Hyiger-Designs/max_breakout/README.md

# MAX7000S Breakout Board
A breadboard and 5V TLL friendly CPLD breakout board
