Hyiger-Designs/max_breakout/images/max_breakout_back.png

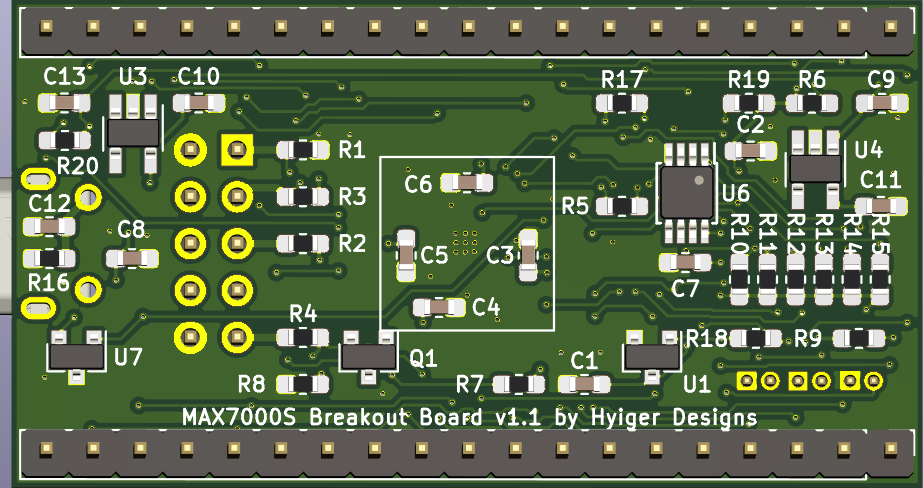
images/max_breakout_back.png
