Hyiger-Designs/max_breakout/images/max_breakout_front.png

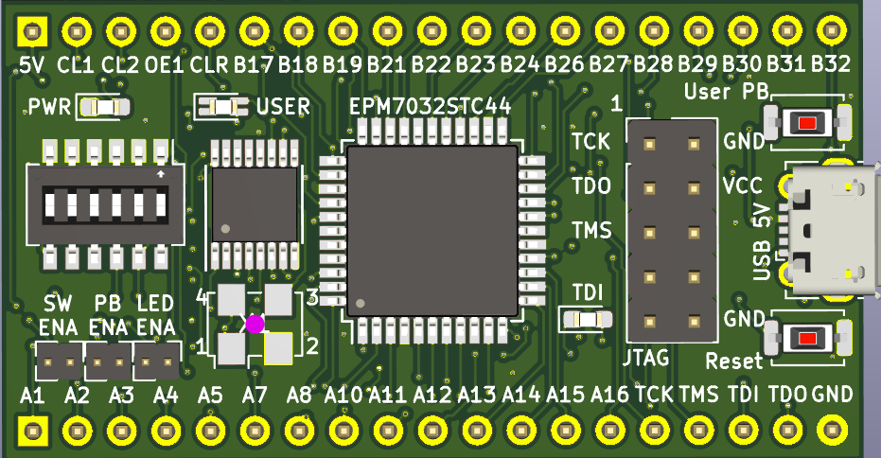
images/max_breakout_front.png
