Hyiger-Designs/max_breakout/max_breakout.xlsx

Refs | Description | MFR | MPN | SPN | SPR | SPURL | datasheet | Footprint | value
C1 | Multilayer Ceramic Capacitors MLCC - SMD/SMT 0603 6.3V 2.2uF 10% X7R | Murata | JMK107B7474KA-T | 963-JMK107B7474KA-T | Mouser | https://www.mouser.com/ProductDetail/963-JMK107B7474KA-T | https://www.mouser.com/datasheet/2/396/mlcc02_e-1307760.pdf | Capacitor_SMD:C_0603_1608Metric_Pad1.05x0.95mm_HandSolder | 2.2uF
C10 | Multilayer Ceramic Capacitors MLCC - SMD/SMT 0603 6.3V 0.33uF 10% X7R | Murata | JMK107B7474KA-T | 963-JMK107B7474KA-T | Mouser | https://www.mouser.com/ProductDetail/963-JMK107B7474KA-T | https://www.mouser.com/datasheet/2/396/mlcc02_e-1307760.pdf | Capacitor_SMD:C_0603_1608Metric_Pad1.05x0.95mm_HandSolder | .33uF
C11 | Multilayer Ceramic Capacitors MLCC - SMD/SMT 0603 6.3V 0..33uF 10% X7R | Murata | JMK107B7474KA-T | 963-JMK107B7474KA-T | Mouser | https://www.mouser.com/ProductDetail/963-JMK107B7474KA-T | https://www.mouser.com/datasheet/2/396/mlcc02_e-1307760.pdf | Capacitor_SMD:C_0603_1608Metric_Pad1.05x0.95mm_HandSolder | .33uF
C12 | Multilayer Ceramic Capacitors MLCC - SMD/SMT 0603 6.3V 100nF 10% X7R | Murata | JMK107B7474KA-T | 963-JMK107B7474KA-T | Mouser | https://www.mouser.com/ProductDetail/963-JMK107B7474KA-T | https://www.mouser.com/datasheet/2/396/mlcc02_e-1307760.pdf | Capacitor_SMD:C_0603_1608Metric_Pad1.05x0.95mm_HandSolder | 100nF
C13 | Multilayer Ceramic Capacitors MLCC - SMD/SMT 0603 6.3V 100nF 10% X7R | Murata | TMK107BJ104KA-T | 963-TMK107BJ104KA-T | Mouser | https://www.mouser.com/ProductDetail/963-TMK107BJ104KA-T | https://www.mouser.com/datasheet/2/396/mlcc02_e-1307760.pdf | Capacitor_SMD:C_0603_1608Metric_Pad1.05x0.95mm_HandSolder | 100nF
C2 | Multilayer Ceramic Capacitors MLCC - SMD/SMT 0603 6.3V 100nF 10% X7R | Murata | JMK107B7474KA-T | 963-JMK107B7474KA-T | Mouser | https://www.mouser.com/ProductDetail/963-JMK107B7474KA-T | https://www.mouser.com/datasheet/2/396/mlcc02_e-1307760.pdf | Capacitor_SMD:C_0603_1608Metric_Pad1.05x0.95mm_HandSolder | 100nF
C3 | Multilayer Ceramic Capacitors MLCC - SMD/SMT 0603 6.3V 100nF 10% X7R | Murata | JMK107B7474KA-T | 963-JMK107B7474KA-T | Mouser | https://www.mouser.com/ProductDetail/963-JMK107B7474KA-T | https://www.mouser.com/datasheet/2/396/mlcc02_e-1307760.pdf | Capacitor_SMD:C_0603_1608Metric_Pad1.05x0.95mm_HandSolder | 100nF
C4 | Multilayer Ceramic Capacitors MLCC - SMD/SMT 0603 6.3V 100nF 10% X7R | Murata | JMK107B7474KA-T | 963-JMK107B7474KA-T | Mouser | https://www.mouser.com/ProductDetail/963-JMK107B7474KA-T | https://www.mouser.com/datasheet/2/396/mlcc02_e-1307760.pdf | Capacitor_SMD:C_0603_1608Metric_Pad1.05x0.95mm_HandSolder | 100nF
C5 | Multilayer Ceramic Capacitors MLCC - SMD/SMT 0603 6.3V 100nF 10% X7R | Murata | JMK107B7474KA-T | 963-JMK107B7474KA-T | Mouser | https://www.mouser.com/ProductDetail/963-JMK107B7474KA-T | https://www.mouser.com/datasheet/2/396/mlcc02_e-1307760.pdf | Capacitor_SMD:C_0603_1608Metric_Pad1.05x0.95mm_HandSolder | 100nF
C7 | Multilayer Ceramic Capacitors MLCC - SMD/SMT 0603 6.3V 100nF 10% X7R | Murata | JMK107B7474KA-T | 963-JMK107B7474KA-T | Mouser | https://www.mouser.com/ProductDetail/963-JMK107B7474KA-T | https://www.mouser.com/datasheet/2/396/mlcc02_e-1307760.pdf | Capacitor_SMD:C_0603_1608Metric_Pad1.05x0.95mm_HandSolder | 100nF
C8 | Multilayer Ceramic Capacitors MLCC - SMD/SMT 0603 6.3V 0.33uF 10% X7R | Murata | JMK107B7474KA-T | 963-JMK107B7474KA-T | Mouser | https://www.mouser.com/ProductDetail/963-JMK107B7474KA-T | https://www.mouser.com/datasheet/2/396/mlcc02_e-1307760.pdf | Capacitor_SMD:C_0603_1608Metric_Pad1.05x0.95mm_HandSolder | .33uF
C9 | Multilayer Ceramic Capacitors MLCC - SMD/SMT 0603 6.3V 0.33uF 10% X7R | Murata | JMK107B7474KA-T | 963-JMK107B7474KA-T | Mouser | https://www.mouser.com/ProductDetail/963-JMK107B7474KA-T | https://www.mouser.com/datasheet/2/396/mlcc02_e-1307760.pdf | Capacitor_SMD:C_0603_1608Metric_Pad1.05x0.95mm_HandSolder | .33uF
D1 | Standard LEDs - SMD RED WATER CLEAR | Kingbright | APT1608EC | 604-APT1608EC | Mouser | https://www.mouser.com/ProductDetail/604-APT1608EC | https://www.mouser.com/datasheet/2/216/APT1608EC-34957.pdf | LED_SMD:LED_0603_1608Metric_Pad1.05x0.95mm_HandSolder | Red
D2 | Standard LEDs - SMD GREEN WATER CLEAR | Kingbright | APT1608SGC | 604-APT1608SGC | Mouser | https://www.mouser.com/ProductDetail/604-APT1608SGC | https://www.mouser.com/datasheet/2/216/APT1608SGC-32861.pdf | LED_SMD:LED_0603_1608Metric_Pad1.05x0.95mm_HandSolder | Green
D3 | Standard LEDs - SMD RGB LED | Inolux | IN-S85TATRGB | 743-IN-S85TATRGB | Mouser | https://www.mouser.com/ProductDetail/Inolux/IN-S85TATRGB | https://www.mouser.com/datasheet/2/180/IN-S85TATRGB_V1.0-1488493.pdf | LED_SMD:IN-S85TATRGB | RGB
J1 |  |  |  |  |  |  | ~ | Connector_PinHeader_2.54mm:PinHeader_1x19_P2.54mm_Vertical | Left
J2 |  |  |  |  |  |  | ~ | Connector_PinHeader_2.54mm:PinHeader_1x19_P2.54mm_Vertical | Right
J3 |  |  |  |  |  |  | ~ | Connector_PinHeader_2.54mm:PinHeader_2x05_P2.54mm_Vertical | AVR-JTAG-10
J4 | USB Connectors 5P Quick Connect Micro USB TypeB Rcpt | Amphenol | 10103594-0001LF | 649-10103594-0001LF | Mouser | https://www.mouser.com/ProductDetail/649-10103594-0001LF | https://www.mouser.com/datasheet/2/18/10103594-1361315.pdf | Connector_USB:USB_Micro-B_Amphenol_10103594-0001LF_Horizontal | USB_B_Micro
Q1 | MOSFET MOSFT P-Ch -3.7A 65mOhm 8nC Log Lvl | Infineon | RLML6402TRPBF | 942-IRLML6402TRPBF | Mouser | https://www.mouser.com/ProductDetail/Infineon-Technologies/IRLML6402TRPBF | https://www.infineon.com/dgdl/irlml6402pbf.pdf?fileId=5546d462533600a401535668d5c2263c | Package_TO_SOT_SMD:SOT-23 | IRLML6402
R1 | Thick Film Resistors - SMD 1K OHM 1% | Bourns | CR0603-FX-1001ELF | 652-CR0603FX-1001ELF | Mouser | https://www.mouser.com/ProductDetail/Bourns/CR0603-FX-1001ELF | https://www.mouser.com/datasheet/2/54/hpreztr-777398.pdf | Resistor_SMD:R_0603_1608Metric_Pad1.05x0.95mm_HandSolder | 1K
R10 | Thick Film Resistors - SMD 10K OHM 1% | Bourns | CR0603-FX-1002ELF | 652-CR0603FX-1002ELF | Mouser | https://www.mouser.com/ProductDetail/Bourns/CR0603-FX-1002ELF | https://www.mouser.com/datasheet/2/54/hpreztr-777398.pdf | Resistor_SMD:R_0603_1608Metric_Pad1.05x0.95mm_HandSolder | 10K
R11 | Thick Film Resistors - SMD 10K OHM 1% | Bourns | CR0603-FX-1002ELF | 652-CR0603FX-1002ELF | Mouser | https://www.mouser.com/ProductDetail/Bourns/CR0603-FX-1002ELF | https://www.mouser.com/datasheet/2/54/hpreztr-777398.pdf | Resistor_SMD:R_0603_1608Metric_Pad1.05x0.95mm_HandSolder | 10K
R12 | Thick Film Resistors - SMD 10K OHM 1% | Bourns | CR0603-FX-1002ELF | 652-CR0603FX-1002ELF | Mouser | https://www.mouser.com/ProductDetail/Bourns/CR0603-FX-1002ELF | https://www.mouser.com/datasheet/2/54/hpreztr-777398.pdf | Resistor_SMD:R_0603_1608Metric_Pad1.05x0.95mm_HandSolder | 10K
R13 | Thick Film Resistors - SMD 10K OHM 1% | Bourns | CR0603-FX-1002ELF | 652-CR0603FX-1002ELF | Mouser | https://www.mouser.com/ProductDetail/Bourns/CR0603-FX-1002ELF | https://www.mouser.com/datasheet/2/54/hpreztr-777398.pdf | Resistor_SMD:R_0603_1608Metric_Pad1.05x0.95mm_HandSolder | 10K
R14 | Thick Film Resistors - SMD 10K OHM 1% | Bourns | CR0603-FX-1002ELF | 652-CR0603FX-1002ELF | Mouser | https://www.mouser.com/ProductDetail/Bourns/CR0603-FX-1002ELF | https://www.mouser.com/datasheet/2/54/hpreztr-777398.pdf | Resistor_SMD:R_0603_1608Metric_Pad1.05x0.95mm_HandSolder | 10K
R15 | Thick Film Resistors - SMD 10K OHM 1% | Bourns | CR0603-FX-1002ELF | 652-CR0603FX-1002ELF | Mouser | https://www.mouser.com/ProductDetail/Bourns/CR0603-FX-1002ELF | https://www.mouser.com/datasheet/2/54/hpreztr-777398.pdf | Resistor_SMD:R_0603_1608Metric_Pad1.05x0.95mm_HandSolder | 10K
R16 | Thick Film Resistors - SMD 1M OHM 1% | Bourns | CR0603-FX-1004ELF | 652-CR0603FX-1004ELF | Mouser | https://www.mouser.com/ProductDetail/603-RC0603JR-071ML | https://www.mouser.com/datasheet/2/54/hpreztr-777398.pdf | Resistor_SMD:R_0603_1608Metric_Pad1.05x0.95mm_HandSolder | 1M
R18 | Thick Film Resistors - SMD 360R 1% | Bourns | CR0603-FX-3600ELF | 652-CR0603FX-3600ELF | Mouser | https://www.mouser.com/ProductDetail/Bourns/CR0603-FX-3600ELF | https://www.mouser.com/datasheet/2/54/hpreztr-777398.pdf | Resistor_SMD:R_0603_1608Metric_Pad1.05x0.95mm_HandSolder | 360R
R2 | Thick Film Resistors - SMD 10K OHM 1% | Bourns | CR0603-FX-1002ELF | 652-CR0603FX-1002ELF | Mouser | https://www.mouser.com/ProductDetail/Bourns/CR0603-FX-1002ELF | https://www.mouser.com/datasheet/2/54/hpreztr-777398.pdf | Resistor_SMD:R_0603_1608Metric_Pad1.05x0.95mm_HandSolder | 10K
R3 | Thick Film Resistors - SMD 10K OHM 1% | Bourns | CR0603-FX-1002ELF | 652-CR0603FX-1002ELF | Mouser | https://www.mouser.com/ProductDetail/Bourns/CR0603-FX-1002ELF | https://www.mouser.com/datasheet/2/54/hpreztr-777398.pdf | Resistor_SMD:R_0603_1608Metric_Pad1.05x0.95mm_HandSolder | 10K
R4 | Thick Film Resistors - SMD 10K OHM 1% | Bourns | CR0603-FX-1002ELF | 652-CR0603FX-1002ELF | Mouser | https://www.mouser.com/ProductDetail/Bourns/CR0603-FX-1002ELF | https://www.mouser.com/datasheet/2/54/hpreztr-777398.pdf | Resistor_SMD:R_0603_1608Metric_Pad1.05x0.95mm_HandSolder | 10K
R5 | Thick Film Resistors - SMD 100R OHM 1% | Bourns | CR0603-FX-1000ELF | 652-CR0603FX-1000ELF | Mouser | https://www.mouser.com/ProductDetail/Bourns/CR0603-FX-1000ELF | https://www.mouser.com/datasheet/2/54/hpreztr-777398.pdf | Resistor_SMD:R_0603_1608Metric_Pad1.05x0.95mm_HandSolder | 100R
R6 | Thick Film Resistors - SMD 360R 1% | Bourns | CR0603-FX-3600ELF | 652-CR0603FX-3600ELF | Mouser | https://www.mouser.com/ProductDetail/Bourns/CR0603-FX-3600ELF | https://www.mouser.com/datasheet/2/54/hpreztr-777398.pdf | Resistor_SMD:R_0603_1608Metric_Pad1.05x0.95mm_HandSolder | 360R
R7 | Thick Film Resistors - SMD 100R OHM 1% | Bourns | CR0603-FX-1000ELF | 652-CR0603FX-1000ELF | Mouser | https://www.mouser.com/ProductDetail/Bourns/CR0603-FX-1000ELF | https://www.mouser.com/datasheet/2/54/hpreztr-777398.pdf | Resistor_SMD:R_0603_1608Metric_Pad1.05x0.95mm_HandSolder | 100R
R8 | Thick Film Resistors - SMD 360R 1% | Bourns | CR0603-FX-3600ELF | 652-CR0603FX-3600ELF | Mouser | https://www.mouser.com/ProductDetail/Bourns/CR0603-FX-3600ELF | https://www.mouser.com/datasheet/2/54/hpreztr-777398.pdf | Resistor_SMD:R_0603_1608Metric_Pad1.05x0.95mm_HandSolder | 360R
R9 | Thick Film Resistors - SMD 10K OHM 1% | Bourns | CR0603-FX-1002ELF | 652-CR0603FX-1002ELF | Mouser | https://www.mouser.com/ProductDetail/Bourns/CR0603-FX-1002ELF | https://www.mouser.com/datasheet/2/54/hpreztr-777398.pdf | Resistor_SMD:R_0603_1608Metric_Pad1.05x0.95mm_HandSolder | 10K
SW1 | Tactile Switches 3.9x2.9x2.0mm 160gf Packaging Temp 80oC | ALPS | SKRKAEE020 | 688-SKRKAEE020 | Mouser | https://www.mouser.com/ProductDetail/688-SKRKAEE020 | https://www.mouser.com/datasheet/2/15/SKRK-1370789.pdf | Button_Switch_SMD:SW_Push_SPST_NO_Alps_SKRK | Reset
SW2 | Tactile Switches 3.9x2.9x2.0mm 160gf Packaging Temp 80oC | ALPS | SKRKAEE020 | 688-SKRKAEE020 | Mouser | https://www.mouser.com/ProductDetail/688-SKRKAEE020 | https://www.mouser.com/datasheet/2/15/SKRK-1370789.pdf | Button_Switch_SMD:SW_Push_SPST_NO_Alps_SKRK | User
SW3 |  |  |  |  | Mouser |  | https://www.mouser.com/datasheet/2/307/en-a6h-1221378.pdf | Button_Switch_SMD:SW_DIP_SPSTx04_Slide_KingTek_DSHP04TS_W7.62mm_P1.27mm | User DIP Switch
SW4 |  |  |  |  | Mouser |  | https://www.mouser.com/datasheet/2/307/en-a6h-1221378.pdf | Button_Switch_SMD:SW_DIP_SPSTx04_Slide_KingTek_DSHP04TS_W7.62mm_P1.27mm | ENA Switch
U1 | LDO Voltage Regulators LDO CMOS LowCurr SOT23 T&R 3K | Diodes Inc | AP7381-33SA-7 | 621-AP7381-33SA-7 | Mouser | https://www.mouser.com/ProductDetail/Diodes-Incorporated/AP7381-33SA-7 | https://www.mouser.com/datasheet/2/115/AP7381-1220674.pdf | Package_TO_SOT_SMD:SOT-23 | AP7381-33SA
U2 | CPLD 32MC 10NS 44TQFP | Intel | EPM7032STC44-10FN |  |  |  | https://media.digikey.com/pdf/Data%20Sheets/Intel%20PDFs/MAX7000_Family_DS.pdf | Package_QFP:TQFP-44_10x10mm_P0.8mm_ThermalVias | EPM7032STC44
U3 | Supervisory Circuits 5V EconoReset w/Pushbutton | Maxim | DS1813R-5+T&R | 700-DS1813R-5T&R | Mouser | https://www.mouser.com/ProductDetail/Maxim-Integrated/DS1813R-5%2BTR?qs=Jw2w9zrI6w%2FjFaF2gE5%2Fbg%3D%3D | https://www.mouser.com/datasheet/2/256/maxim%20integrated%20products_ds1813-1178753.pdf | Package_TO_SOT_SMD:SOT-23 | DS1813R-5+T&R
U4 | Supervisory Circuits Current Sense/Ideal Diode | Maxim | MAX40200AUK+T | 700-MAX40200AUK+T | Mouser | https://www.mouser.com/ProductDetail/Maxim-Integrated/MAX40200AUK%2BT?qs=5aG0NVq1C4yORXmgClGWGQ%3D%3D | https://www.mouser.com/datasheet/2/256/MAX40200-1112995.pdf | Package_TO_SOT_SMD:SOT-23-5_HandSoldering | MAX40200AUK
U5 | Supervisory Circuits Current Sense/Ideal Diode | Maxim | MAX40200AUK+T | 700-MAX40200AUK+T | Mouser | https://www.mouser.com/ProductDetail/Maxim-Integrated/MAX40200AUK%2BT?qs=5aG0NVq1C4yORXmgClGWGQ%3D%3D | https://www.mouser.com/datasheet/2/256/MAX40200-1112995.pdf | Package_TO_SOT_SMD:SOT-23-5_HandSoldering | MAX40200AUK
U6 | Buffers & Line Drivers OCTAL BUFFER 3-STATE | Nexperia | 74HCT244PW,118 | 771-HCT244PW118 | Mouser | https://www.mouser.com/ProductDetail/Nexperia/74HCT244PW118?qs=sGAEpiMZZMuiiWkaIwCK2RTxPVPWGz6W2P5hwMtP2Rs%3D | https://assets.nexperia.com/documents/data-sheet/74HC_HCT244.pdf | Package_SO:TSSOP-20_4.4x6.5mm_P0.65mm | 74HCT244
X1 | 50Mhz Clock Oscillator, 3.3V, HCMOS,TTL | CTS | 636L3C050M00000 | 774-636L3C050M00000 | Mouser | https://www.mouser.com/ProductDetail/CTS-Electronic-Components/636L3C050M00000 | https://www.mouser.com/datasheet/2/96/008-0250-0-786318.pdf | Oscillator:Oscillator_SMD_TXC_7C-4Pin_5.0x3.2mm_HandSoldering | CTX-636 50mhz
