Hyiger-Designs/max_breakout/docs/max_breakout.pdf

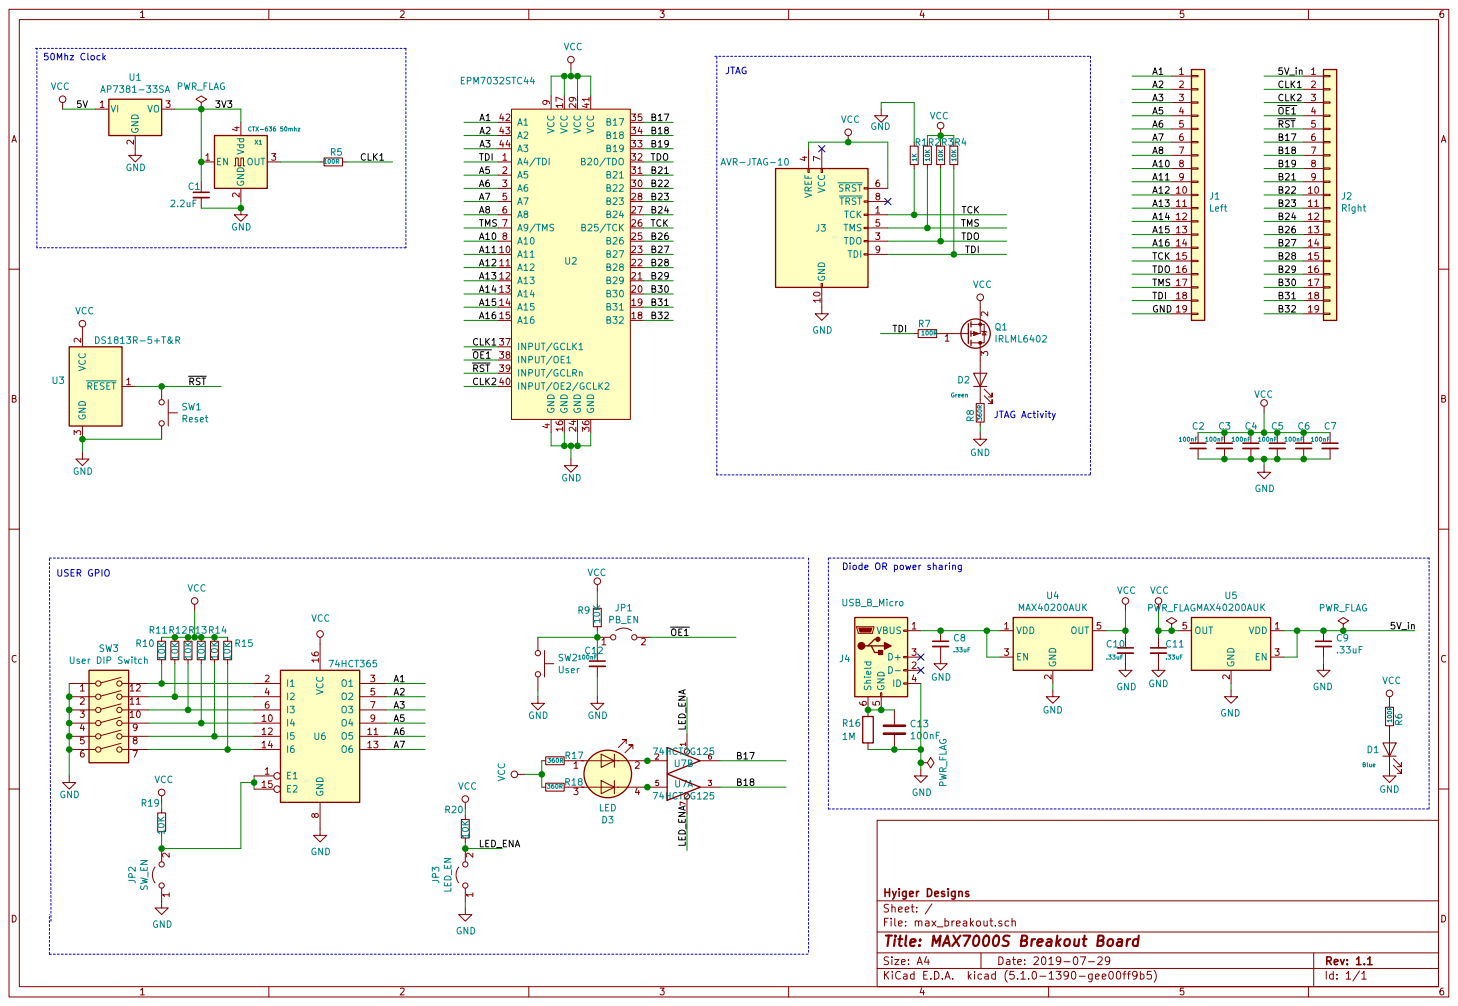
[picture p3: page 1]

Diode OR power sharing

File: max_breakout.sch Sheet: / Hyiger Designs

Id: 1/1 Title: MAX7000S Breakout Board
