Hyiger-Designs/max_breakout/max_breakout_sch.pdf

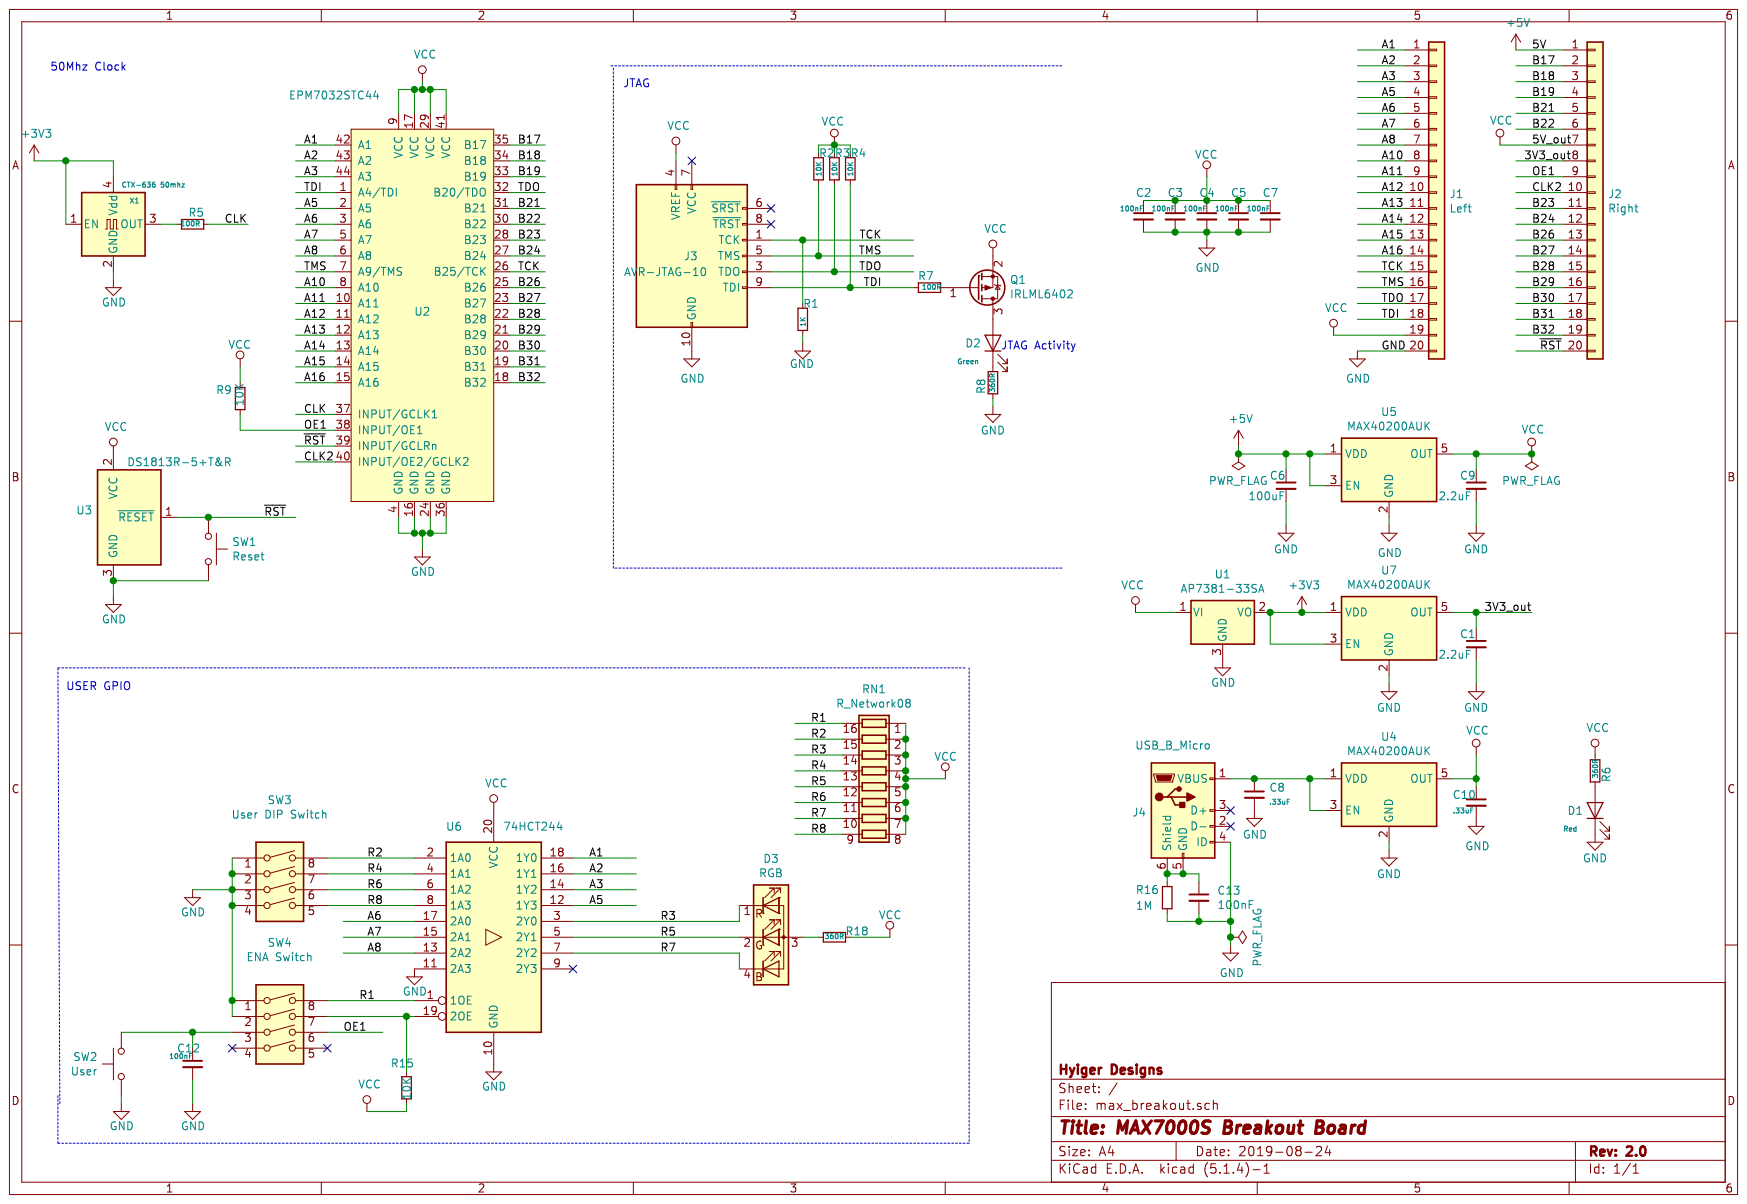
[picture p4: page 1]
