Hyiger-Designs/max_breakout/max_breakout.kicad_pcb

## KiCad design max_breakout.kicad_pcb (2021-03-13)

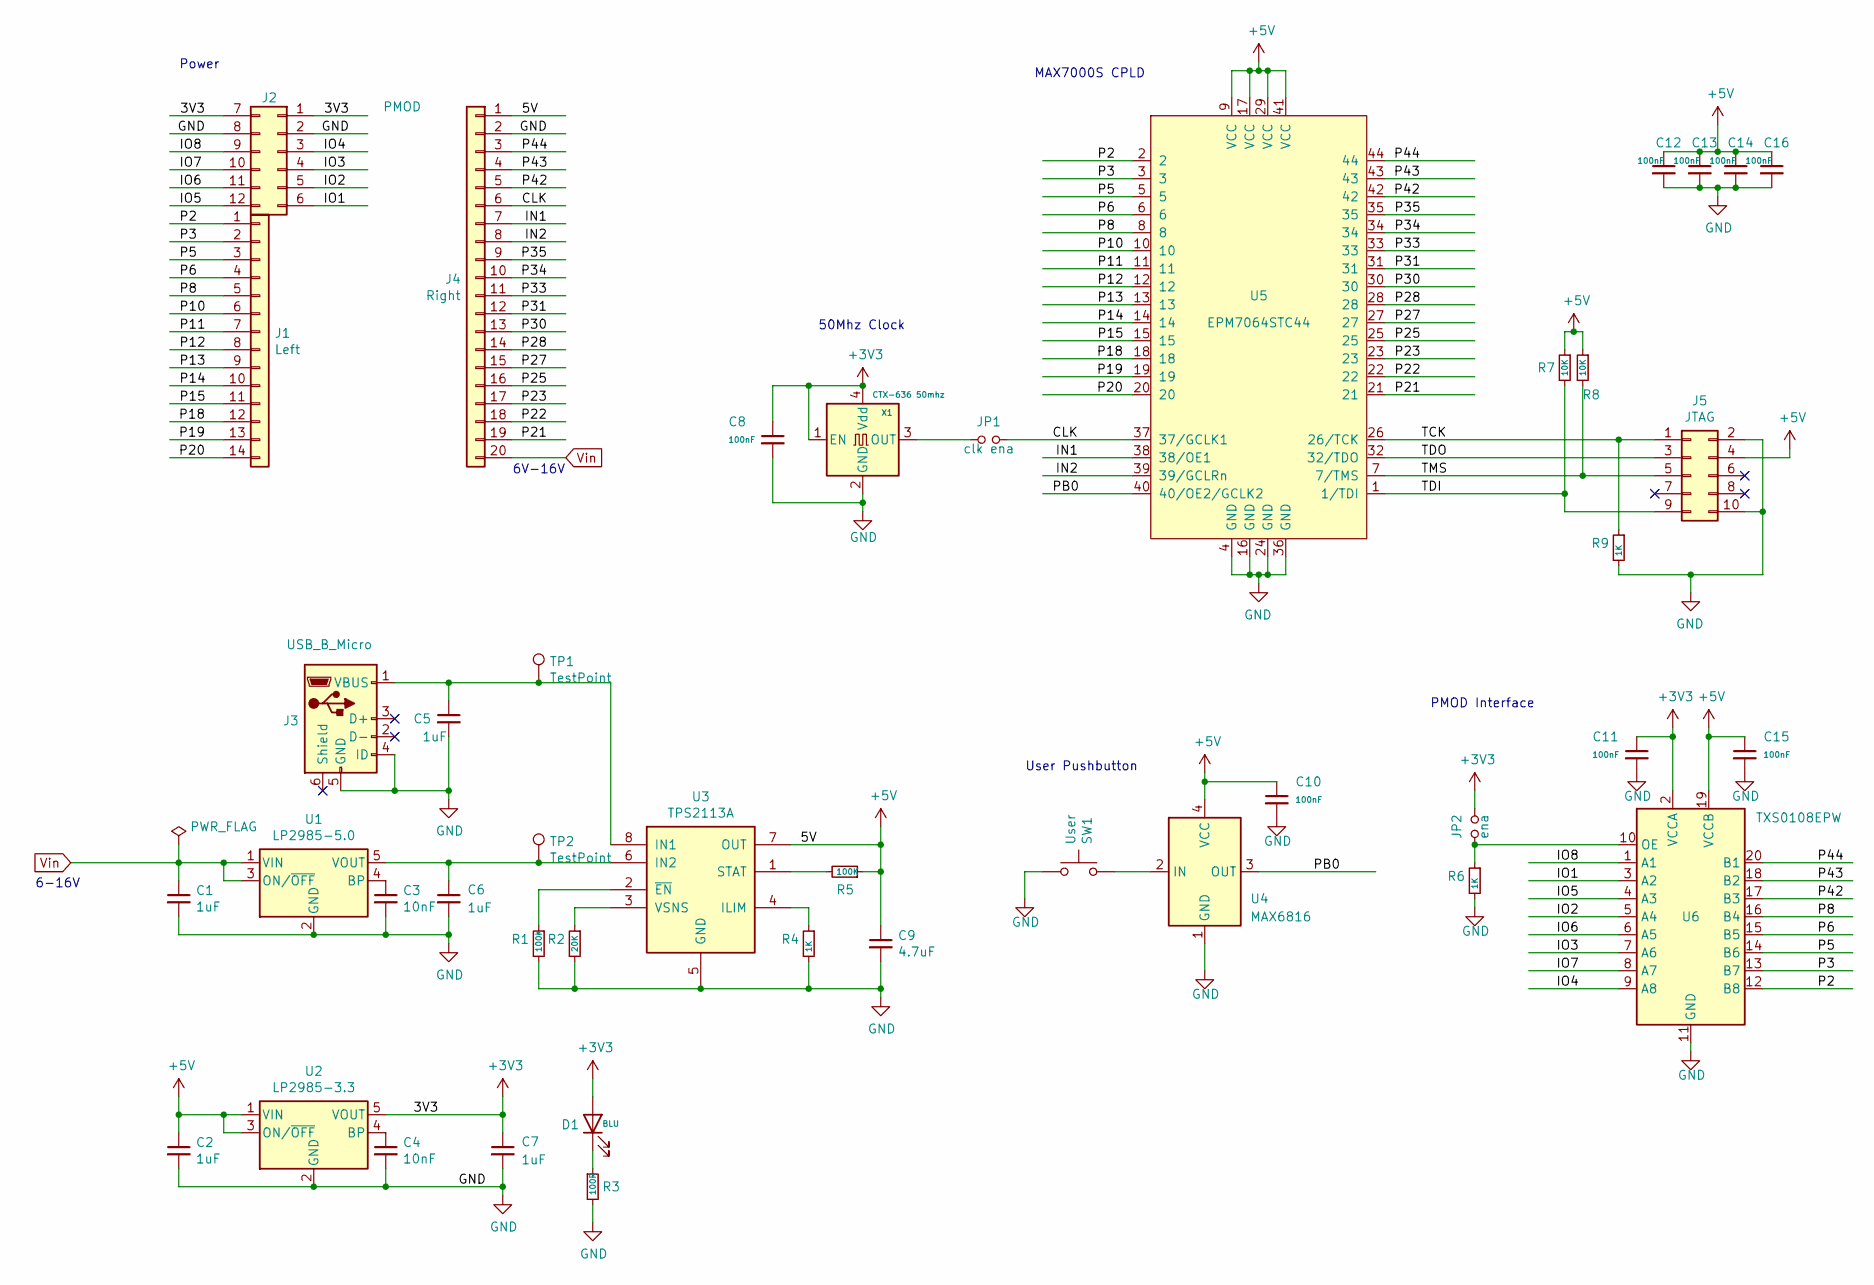
[picture p5: schematic max_breakout.sch, MAX7000S Breakout Board]

Parts:
C1, C2, C5, C6, C7: 1uF; C_0603_1608Metric_Pad1.08x0.95mm_HandSolder; MPN C0603C105K3PACTU
C3, C4: 10nF; C_0603_1608Metric_Pad1.05x0.95mm_HandSolder; MPN C0603C103J5RACTU
C8, C10, C11, C12, C13, C14, C15, C16: 100nF; C_0603_1608Metric_Pad1.08x0.95mm_HandSolder; MPN C0603C104J5RACTU
C9: 4.7uF; C_0603_1608Metric_Pad1.05x0.95mm_HandSolder; MPN C0603C475K8PACTU
D1: BLU; LED_0603_1608Metric_Pad1.05x0.95mm_HandSolder; MPN SMLD12BN1WT86
J1: Left; PinHeader_1x14_P2.54mm_Vertical
J2: PMOD; PinSocket_2x06_Top_Bottom_P2.54mm_Horizontal
J3: USB_B_Micro; USB_Micro-B_Amphenol_10103594-0001LF_Horizontal; MPN 10103594-0001LF
J4: Right; PinHeader_1x20_P2.54mm_Vertical
J5: JTAG; PinHeader_2x05_P2.54mm_Vertical
JP1: clk ena; PinHeader_1x02_P2.54mm_Vertical
JP2: ena; PinHeader_1x02_P2.54mm_Vertical
R1, R5: 100K; R_0603_1608Metric_Pad1.05x0.95mm_HandSolder; MPN CR0603-FX-1003ELF
R2: 20K; R_0603_1608Metric_Pad1.05x0.95mm_HandSolder; MPN CR0603-FX-2002ELF
R3: 100R; R_0603_1608Metric_Pad1.05x0.95mm_HandSolder; MPN CR0603-FX-1001ELF
R4, R6, R9: 1K; R_0603_1608Metric_Pad1.05x0.95mm_HandSolder; MPN CR0603-FX-1001ELF
R7, R8: 10K; R_0603_1608Metric_Pad1.05x0.95mm_HandSolder; MPN CR0603-FX-1002ELF
SW1: User; SW_Push_SPST_NO_Alps_SKRK; MPN SKRKAEE020
TP1, TP2: TestPoint; TestPoint_Pad_D1.5mm
U1: LP2985-5.0; SOT-23-5; MPN LP2985-50DBVR
U2: LP2985-3.3; SOT-23-5; MPN LP2985-33DBVR
U3: TPS2113A; TSSOP-8_4.4x3mm_P0.65mm; MPN TPS2113APWR
U4: MAX6816; SOT-143; MPN MAX6816EUS+T
U5: EPM7064STC44; TQFP-44_10x10mm_P0.8mm; MPN EPM7064STC44-10N
U6: TXS0108EPW; TSSOP-20_4.4x6.5mm_P0.65mm; MPN TXS0108EPWR
X1: CTX-636 50mhz; Oscillator_SMD_TXC_7C-4Pin_5.0x3.2mm_HandSoldering; MPN 636L3C050M00000

Connections:
+3V3: C7.1, C8.1, C11.1, D1.2 (A), J2.1, J2.7, JP2.2, U2.5 (VOUT), U6.2 (VCCA), X1.1 (EN), X1.4 (Vdd)
+5V: C2.1, C9.1, C10.1, C12.1, C13.1, C14.1, C15.1, C16.1, J4.1, J5.4, R5.1, R7.1, R8.1, U2.1 (VIN), U2.3 (ON/~OFF~), U3.7 (OUT), U4.4 (VCC), U5.9 (VCC), U5.17 (VCC), U5.29 (VCC), U5.41 (VCC), U6.19 (VCCB)
/CLK: J4.6, JP1.1, U5.37 (37/GCLK1)
/IN1: J4.7, U5.38 (38/OE1)
/IN2: J4.8, U5.39 (39/GCLRn)
/IO1: J2.6, U6.3 (A2)
/IO2: J2.5, U6.5 (A4)
/IO3: J2.4, U6.7 (A6)
/IO4: J2.3, U6.9 (A8)
/IO5: J2.12, U6.4 (A3)
/IO6: J2.11, U6.6 (A5)
/IO7: J2.10, U6.8 (A7)
/IO8: J2.9, U6.1 (A1)
/P2: J1.1, U5.2, U6.12 (B8)
/P3: J1.2, U5.3, U6.13 (B7)
/P5: J1.3, U5.5, U6.14 (B6)
/P6: J1.4, U5.6, U6.15 (B5)
/P8: J1.5, U5.8, U6.16 (B4)
/P10: J1.6, U5.10
/P11: J1.7, U5.11
/P12: J1.8, U5.12
/P13: J1.9, U5.13
/P14: J1.10, U5.14
/P15: J1.11, U5.15
/P18: J1.12, U5.18
/P19: J1.13, U5.19
/P20: J1.14, U5.20
/P21: J4.19, U5.21
/P22: J4.18, U5.22
/P23: J4.17, U5.23
/P25: J4.16, U5.25
/P27: J4.15, U5.27
/P28: J4.14, U5.28
/P30: J4.13, U5.30
/P31: J4.12, U5.31
/P33: J4.11, U5.33
/P34: J4.10, U5.34
/P35: J4.9, U5.35
/P42: J4.5, U5.42, U6.17 (B3)
/P43: J4.4, U5.43, U6.18 (B2)
/P44: J4.3, U5.44, U6.20 (B1)
/PB0: U4.3 (OUT), U5.40 (40/OE2/GCLK2)
/TCK: J5.1, R9.1, U5.26 (26/TCK)
/TDI: J5.9, R7.2, U5.1 (1/TDI)
/TDO: J5.3, U5.32 (32/TDO)
/TMS: J5.5, R8.2, U5.7 (7/TMS)
GND: C1.2, C2.2, C3.2, C4.2, C5.2, C6.2, C7.2, C8.2, C9.2, C10.2, C11.2, C12.2, C13.2, C14.2, C15.2, C16.2, J2.2, J2.8, J3.4 (ID), J3.5 (GND), J4.2, J5.2, J5.10, R1.2, R2.2, R3.2, R4.2, R6.2, R9.2, SW1.2, U1.2 (GND), U2.2 (GND), U3.5 (GND), U4.1 (GND), U5.4 (GND), U5.16 (GND), U5.24 (GND), U5.36 (GND), U6.11 (GND), X1.2 (GND)
unnamed: C3.1, U1.4 (BP)
unnamed: C4.1, U2.4 (BP)
unnamed: C5.1, J3.1 (VBUS), TP1.1, U3.8 (IN1)
unnamed: C6.1, TP2.1, U1.5 (VOUT), U3.6 (IN2)
unnamed: D1.1 (K), R3.1
unnamed: JP1.2, X1.3 (OUT)
unnamed: JP2.1, R6.1, U6.10 (OE)
unnamed: R1.1, U3.2 (~EN)
unnamed: R2.1, U3.3 (VSNS)
unnamed: R4.1, U3.4 (ILIM)
unnamed: R5.2, U3.1 (STAT)
unnamed: SW1.1, U4.2 (IN)
Vin: C1.1, J4.20, U1.1 (VIN), U1.3 (ON/~OFF~)

Notes on the sheet:
User Pushbutton
50Mhz Clock
MAX7000S CPLD
Power
6-16V
6V-16V
PMOD Interface

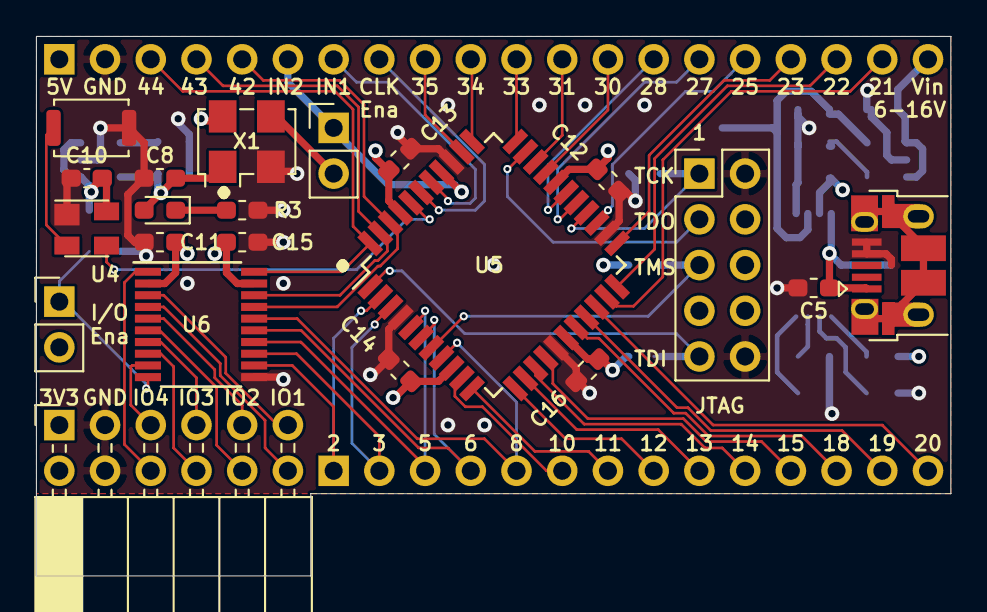
[picture p6: board max_breakout.kicad_pcb from above]

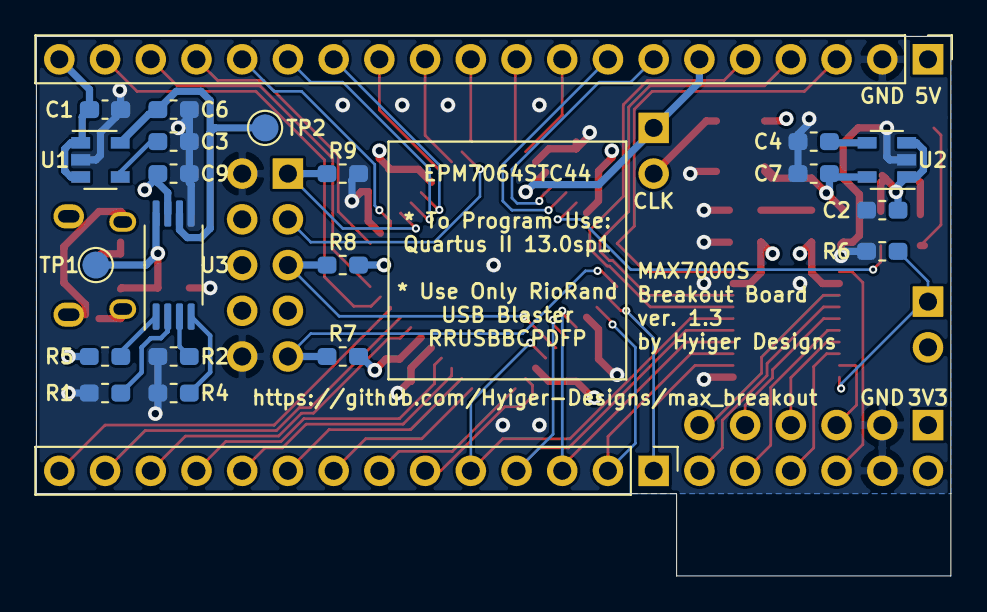
[picture p7: board max_breakout.kicad_pcb from below]

Board: 4 copper layers, 50.8 x 30.0 mm, 43 parts (22 on the bottom side), 60 nets.
