Hyiger-Designs/max_breakout/(commit log)

2019-07-19 initial version
    [max_breakout.kicad_pcb, max_breakout.sch]
2019-07-20 switched to 32pins
    [max_breakout.kicad_pcb, max_breakout.sch]
2019-07-21 reorganized parts
    [max_breakout.kicad_pcb, max_breakout.sch]
2019-07-21 removed bus
    [max_breakout.kicad_pcb, max_breakout.sch]
2019-07-22 added voltage stepdown for xtal
    [max_breakout.kicad_pcb, max_breakout.sch]
2019-07-24 finished layout
    [max_breakout.kicad_pcb, max_breakout.sch]
2019-07-24 start routing
    [max_breakout.kicad_pcb, max_breakout.sch]
2019-07-25 version 1.0
    [max_breakout.kicad_pcb, max_breakout.sch]
2019-07-29 replaced led with ldo regulator
    [max_breakout.kicad_pcb]
2019-07-29 added reset and user push buttons
    [max_breakout.kicad_pcb]
2019-07-30 docs, images and gerbers
    [max_breakout-B_Cu.gbr, max_breakout-B_Mask.gbr, max_breakout-B_Paste.gbr, max_breakout-B_SilkS.gbr, max_breakout-Edge_Cuts.gbr, max_breakout-F_Cu.gbr, max_breakout-F_Mask.gbr, max_breakout-F_Paste.gbr]
2019-07-30 changed layout
    [max_breakout.kicad_pcb, max_breakout.sch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]
2019-07-30 version 1.1
    [max_breakout.kicad_pcb, max_breakout.sch]
2019-07-30 Updated gerbers
    [max_breakout-B_Cu.gbr, max_breakout-B_Mask.gbr, max_breakout-B_Paste.gbr, max_breakout-B_SilkS.gbr, max_breakout-Edge_Cuts.gbr, max_breakout-F_Cu.gbr, max_breakout-F_Mask.gbr, max_breakout-F_Paste.gbr]
2019-07-31 fixed up gnd planes
    [max_breakout.kicad_pcb, max_breakout.sch]
2019-08-25 fixed 3.3v reg pinouts, added thermal vias
    [max_breakout.csv, max_breakout.kicad_pcb, max_breakout.sch]
2019-08-27 rerouted and updated BOM
    [max_breakout.kicad_pcb, max_breakout.sch, max_breakout.xlsx]
2019-08-27 Fixed up library references
    [max_breakout.sch]
2019-08-27 changed field references
    [max_breakout.kicad_pcb]
2019-08-28 fixed jtag pin, pull oe1 high
    [max_breakout.kicad_pcb, max_breakout.sch]
2019-08-28 fixed buffer layout
    [max_breakout.kicad_pcb, max_breakout.sch]
2019-08-29 fixed design rules. rerouting for noise reductions
    [max_breakout.kicad_pcb]
2019-08-29 changed 20pin headers
    [max_breakout.kicad_pcb]
2019-08-30 new routing and gnd plane
    [max_breakout.kicad_pcb, max_breakout.sch]
2019-08-30 more routing
    [max_breakout.kicad_pcb]
2019-08-30 updated routing and gerbers
    [max_breakout-B_Cu.gbr, max_breakout-B_Mask.gbr, max_breakout-B_Paste.gbr, max_breakout-B_SilkS.gbr, max_breakout-Edge_Cuts.gbr, max_breakout-F_Cu.gbr, max_breakout-F_Mask.gbr, max_breakout-F_Paste.gbr]
2019-08-31 fixed dip switch footprints, separated component vcc's
    [max_breakout.kicad_pcb, max_breakout.sch]
2019-09-01 better part alignment
    [max_breakout-B_Cu.gbr, max_breakout-B_Mask.gbr, max_breakout-B_SilkS.gbr, max_breakout-Edge_Cuts.gbr, max_breakout-F_Cu.gbr, max_breakout-F_Mask.gbr, max_breakout-F_SilkS.gbr, max_breakout-In1_Cu.gbr]
2019-09-01 aligned traces
    [max_breakout.kicad_pcb]
2019-09-03 version 2.0
    [max_breakout.kicad_pcb]
2019-09-09 straighten traces
    [max_breakout.kicad_pcb]
2019-09-24 fixed gnd plane breaks
    [max_breakout.kicad_pcb, max_breakout.sch]
2019-09-24 removed TDO pull-up, added JTAG bypass
    [max_breakout.kicad_pcb, max_breakout.sch]
2019-09-26 Added 5V and 3V3 regulators. Fixed USB GND issue
    [max_breakout.kicad_pcb, max_breakout.sch]
2019-09-26 do over
    [max_breakout.kicad_pcb]
2019-09-26 realigned parts
    [max_breakout.kicad_pcb, max_breakout.sch]
2019-09-30 fixed ground breaks
    [max_breakout.kicad_pcb, max_breakout.sch]
2019-10-09 reorganized part layout, replace mosfet with inverter
    [max_breakout.kicad_pcb, max_breakout.sch]
2019-10-10 track cleanup
    [max_breakout.kicad_pcb, max_breakout.sch]
2019-10-15 removed switches
    [max_breakout.kicad_pcb, max_breakout.sch]
2019-10-16 finished routing
    [max_breakout.kicad_pcb]
2019-10-17 fixed gnd breaks
    [max_breakout.kicad_pcb]
2019-12-29 removed extra cap from reg outputs
    [max_breakout.kicad_pcb, max_breakout.sch]
2020-05-08 Replaced RGB with leds. Reorganized switches. pulldowns for OE and RST
    [max_breakout.kicad_pcb, max_breakout.sch]
2020-05-08 smaller footprint for IC2, fixed thermal vias
    [max_breakout.kicad_pcb]
2020-05-09 fixed silkscreen, added gnd thermal reliefs
    [max_breakout.kicad_pcb]
2020-05-09 added open-drain clock driver, pull-ups for JTAG, removed TDI led
    [max_breakout.kicad_pcb, max_breakout.sch]
2020-05-09 fixed layout of regulators
    [max_breakout.kicad_pcb, max_breakout.sch]
2020-05-09 added level shifter on clock
    [max_breakout.kicad_pcb, max_breakout.sch]
2020-05-10 removed extraneous pullups
    [max_breakout.kicad_pcb, max_breakout.sch]
2020-05-10 rewired pushbuttons to input pins
    [max_breakout.kicad_pcb, max_breakout.sch]
2020-05-10 fixed unconnected errors
    [max_breakout.kicad_pcb]
2020-05-10 switches push buttons and leds to active high, silk screen enhancements
    [max_breakout.kicad_pcb, max_breakout.sch]
2020-05-10 schematic cleanup
    [max_breakout.kicad_pcb, max_breakout.sch]
2020-05-10 fixed silkscreen
    [max_breakout.kicad_pcb]
2020-05-11 tweaked silkscreen
    [max_breakout-B_Cu.gbr, max_breakout-B_Mask.gbr, max_breakout-B_SilkS.gbr, max_breakout-Edge_Cuts.gbr, max_breakout-F_Cu.gbr, max_breakout-F_Mask.gbr, max_breakout-F_SilkS.gbr, max_breakout-In1_Cu.gbr]
2020-05-13 made USB shield a NC, add nofill region around xtal
    [max_breakout.kicad_pcb, max_breakout.sch]
2020-05-14 Added power mux, removed pb1
    [max_breakout.kicad_pcb, max_breakout.sch]
2020-05-15 changes to gnd plane and keepout areas
    [max_breakout.kicad_pcb, max_breakout.sch]
2020-05-15 added ferrite bead
    [max_breakout.kicad_pcb, max_breakout.sch]
2020-05-27 added TDI pullup
    [max_breakout.csv, max_breakout.kicad_pcb, max_breakout.sch]
2020-05-27 cleaned up silkscreen and traces
    [max_breakout.kicad_pcb]
2020-08-05 Added thermal reliefs
    [max_breakout.kicad_pcb]
2020-08-10 replace jtag with standard connector
    [max_breakout.kicad_pcb, max_breakout.sch]
2020-08-10 silkscreen fixes, component layout
    [max_breakout.kicad_pcb, max_breakout.sch]
2020-08-20 Added pmod
    [max_breakout.kicad_pcb, max_breakout.sch]
2020-08-20 Reorganized pins
    [max_breakout.kicad_pcb, max_breakout.sch]
2020-08-21 added pmod connector
    [max_breakout.kicad_pcb, max_breakout.sch]
2020-08-22 removed leds, added full pmod
    [max_breakout.kicad_pcb, max_breakout.sch]
2020-08-22 replaced level translator with push-pull version
    [max_breakout.kicad_pcb, max_breakout.sch]
2020-08-25 added gnd and input pins
    [max_breakout.kicad_pcb, max_breakout.sch]
2020-08-28 Silkscreen adjustments
    [max_breakout.kicad_pcb, max_breakout.sch]
2020-09-04 flipped some components to front-side
    [max_breakout.kicad_pcb, max_breakout.sch]
2020-09-07 reorganized 3v3 parts
    [max_breakout.kicad_pcb, max_breakout.sch]
2020-09-07 consolidated pwr supply
    [max_breakout.kicad_pcb, max_breakout.sch]
2020-09-08 silkscreen updates
    [max_breakout.kicad_pcb, max_breakout.sch]
2020-09-23 corrected pin names, simplified PCB
    [max_breakout.kicad_pcb, max_breakout.sch]
2020-09-23 initial VHDL source for LED pmod
2020-10-03 added clock and uart VHDL projects
    [max_breakout.kicad_pcb]
2020-10-03 rotated FPGA, reassigned pins
    [max_breakout.kicad_pcb, max_breakout.sch]
2020-10-26 added back led_pmod
2021-01-24 Simplified power supply
    [max_breakout.kicad_pcb, max_breakout.sch]
2021-02-06 reorganized 3V3 pwr
    [max_breakout.kicad_pcb]
2021-03-13 Test points and silkscreen improvements
    [max_breakout.kicad_pcb, max_breakout.sch]
